doesntfazer/Ch55p34-keyboard/BOM/BOMJLC.csv

Comment | Designator | Footprint | LCSC Part #
1N4148W | D1, D2, D3, D4, D5, D6, D7, D8, D9, D10, D11, D12, D13, D14, D15, D16, D17, D18, D19, D20, D21, D22, D23, D24, D25, D26, D27, D28, D29, D30, D31, D32, D33, D34 | D_SOD-123 | C25133
5.1k | R1, R2 | R_0805_2012Metric | C27834
330R | R3 | R_0805_2012Metric | C17630
10K | R4 | R_0805_2012Metric | C17414
100n | C1, C2, C3 | C_0805_2012Metric | C49678
CH552T | U1 | TSSOP-20_4.4x6.5mm_P0.65mm | C111367
Type-C | J1 | USB_C_Receptacle_HRO_TYPE-C-31-M-12 | C165948
