doesntfazer/Ch55p34-keyboard/Case Files/midplate.stl

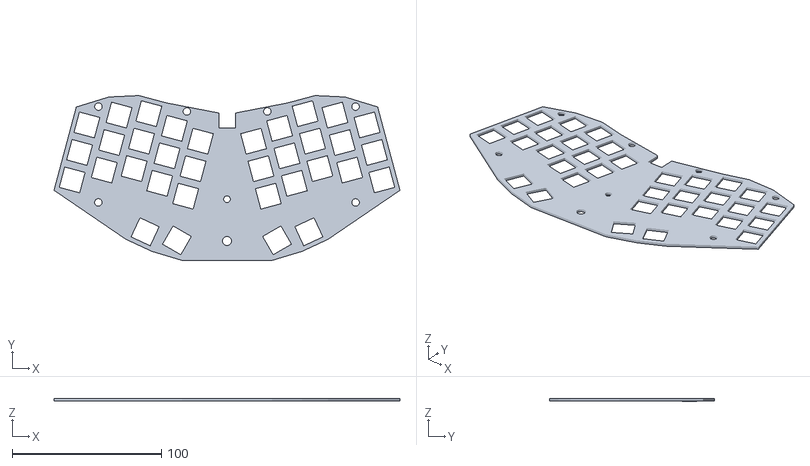
[picture p3: CAD file, 2024-01-23]
Case Files/midplate.stl
231.6 x 110.4 x 2.00
