doesntfazer/Ch55p34-keyboard/DXF/ch55p34-F_Cu.dxf

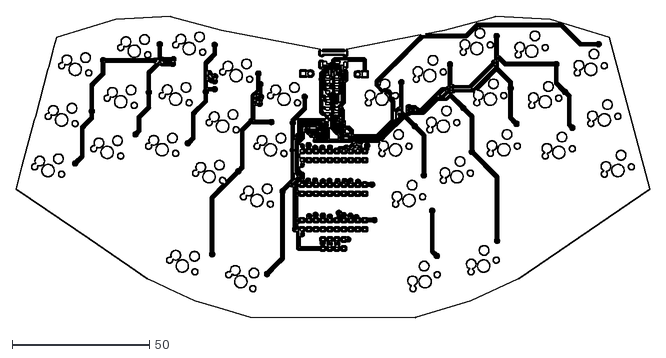
[picture p4: CAD file, 2024-01-17]
DXF/ch55p34-F_Cu.dxf
230.6 x 109.5
