doesntfazer/Ch55p34-keyboard/Case Files/Case.stl

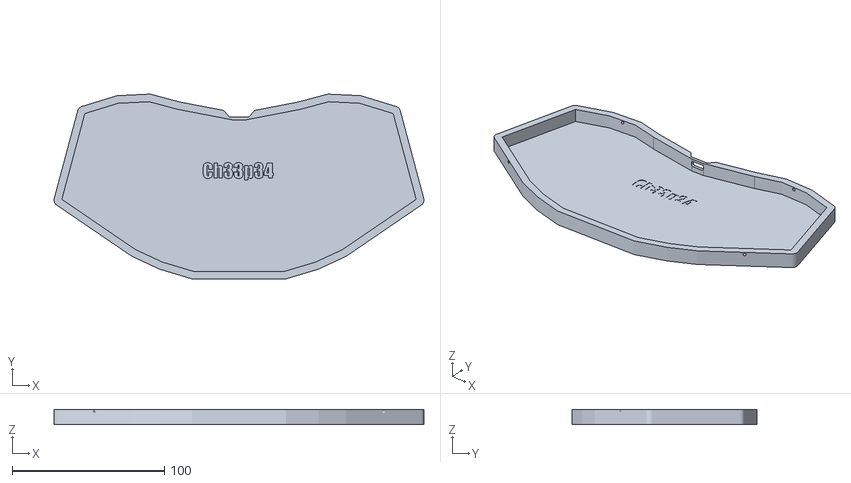
[picture p5: CAD file, 2024-01-17]
Case Files/Case.stl
243.1 x 121.4 x 10.0
