doesntfazer/Ch55p34-keyboard/DXF/ch55p34-F_Fab.dxf

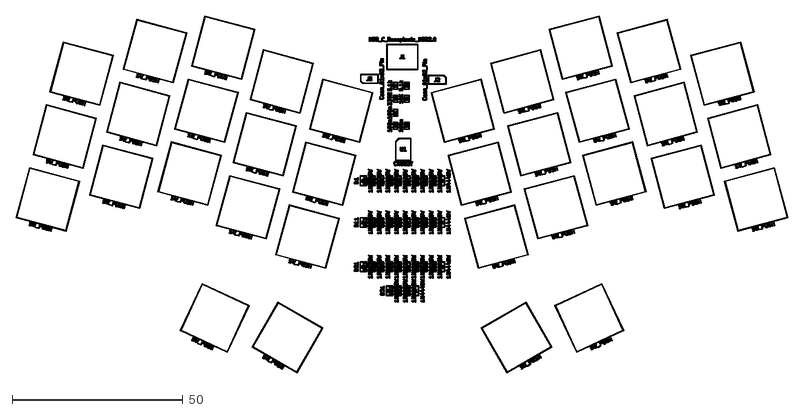
[picture p6: CAD file, 2024-01-17]
DXF/ch55p34-F_Fab.dxf
225.8 x 104.4
