doesntfazer/Ch55p34-keyboard/Case Files/plate.stl

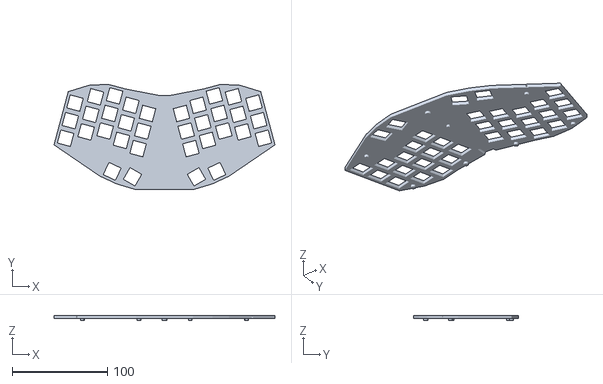
[picture p7: CAD file, 2024-01-17]
Case Files/plate.stl
231.6 x 110.4 x 5.00
