doesntfazer/Ch55p34-keyboard/DXF/ch55p34-Edge_Cuts.dxf

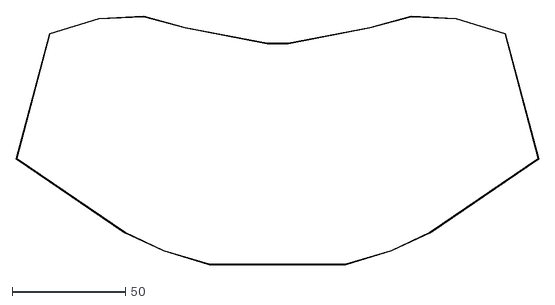
[picture p8: CAD file, 2024-01-17]
DXF/ch55p34-Edge_Cuts.dxf
230.7 x 109.6
