doesntfazer/Ch55p34-keyboard/(list of files, cad)

Other CAD files:
DXF/ch55p34-B_Mask.dxf
DXF/ch55p34-B_Paste.dxf
DXF/ch55p34-B_Silkscreen.dxf
DXF/ch55p34-F_Mask.dxf
DXF/ch55p34-F_Paste.dxf
DXF/ch55p34-F_Silkscreen.dxf
