doesntfazer/Ch55p34-keyboard/ch55p34/ch55p34.kicad_sch

## KiCad design ch55p34/ch55p34.kicad_sch (2024-01-05)

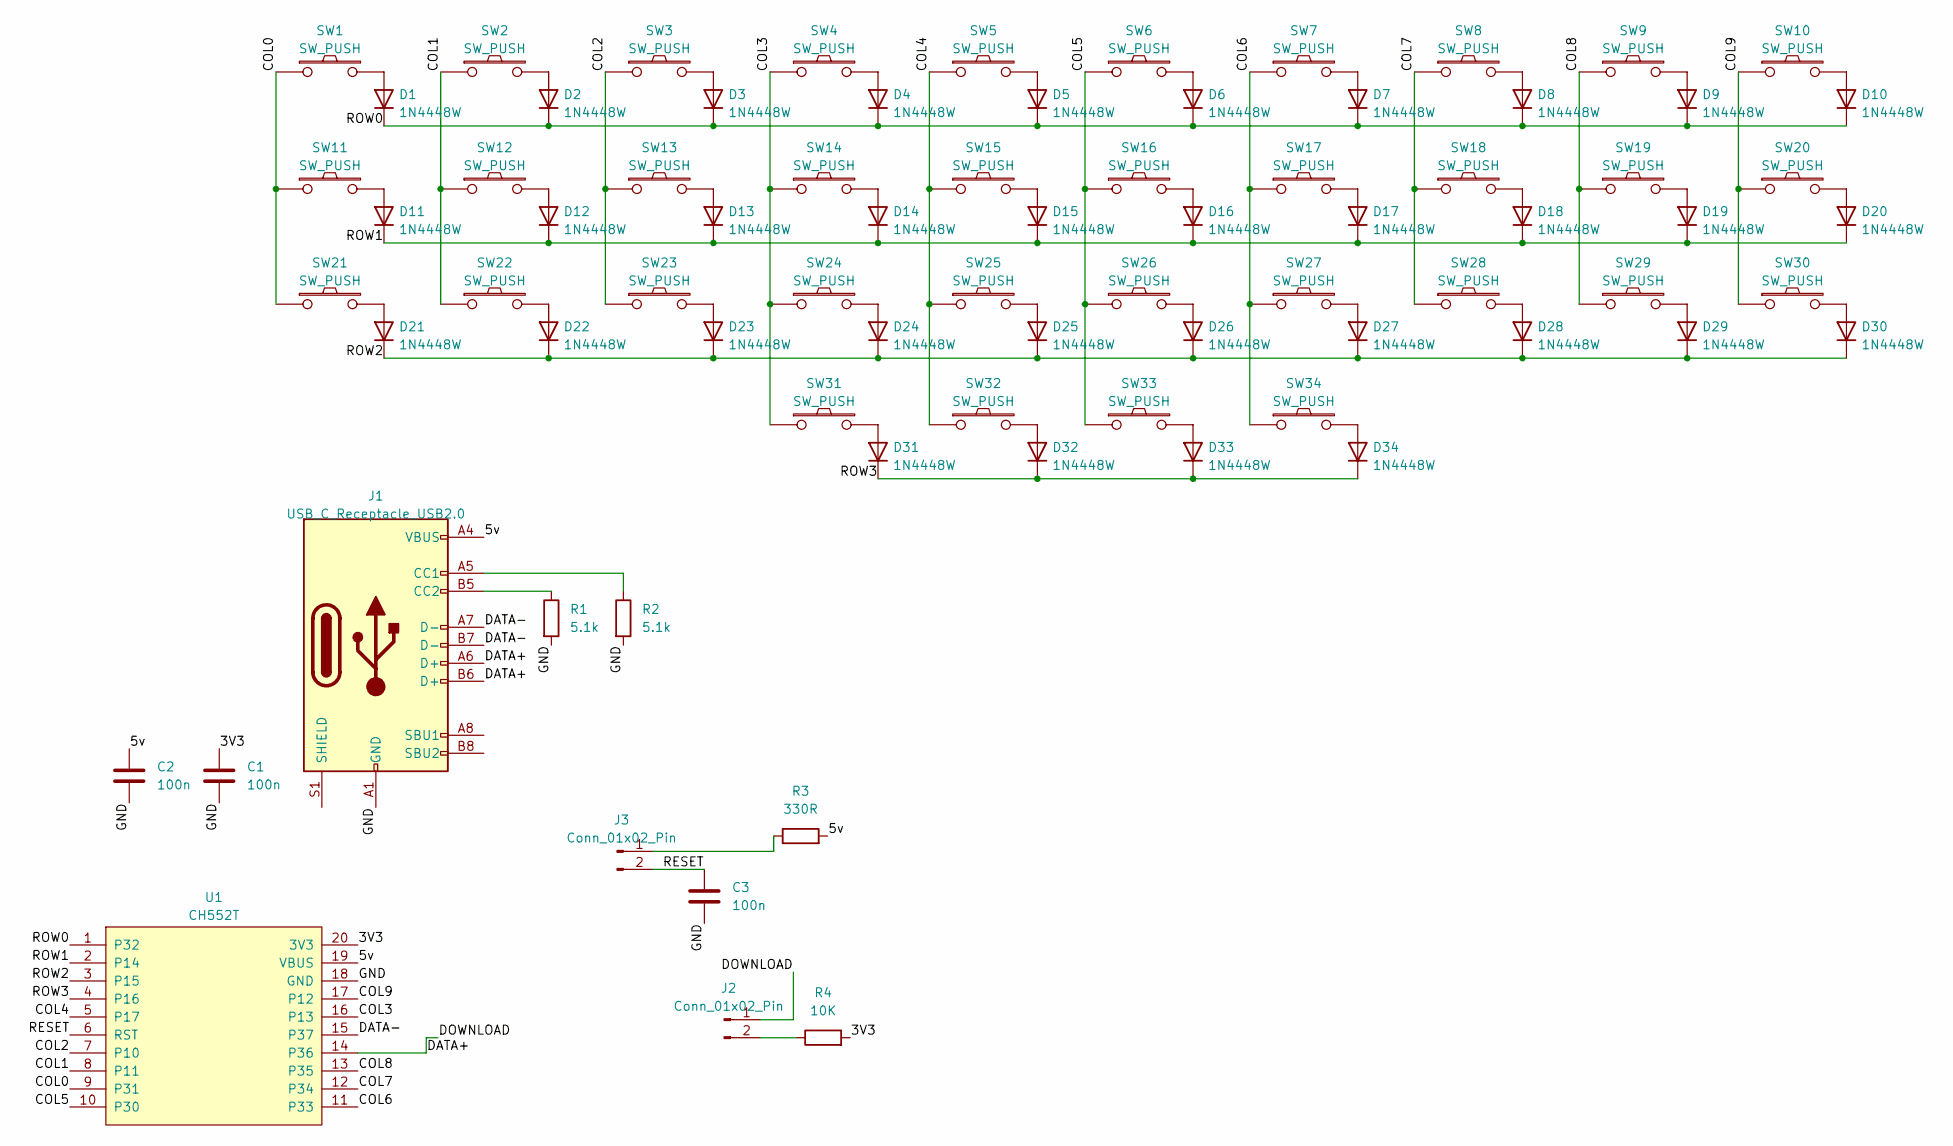
[picture p10: schematic ch55p34.kicad_sch]

Parts:
C1, C2, C3: 100n; C_0805_2012Metric; LCSC C49678
D1: 1N4448W; D_SOD-123; LCSC C9808
D2, D3, D4, D5, D6, D7, D8, D9, D10, D11, D12, D13, D14, D15, D16, D17, D18, D19, D20, D21, D22, D23, D24, D25, D26, D27, D28, D29, D30, D31, D32, D33, D34: 1N4448W; D_SOD-123
J1: USB_C_Receptacle_USB2.0; USB_C_Receptacle_HRO_TYPE-C-31-M-12
J2, J3: Conn_01x02_Pin; PinHeader_1x02_P2.54mm_Vertical
R1, R2: 5.1k; R_0805_2012Metric; LCSC C27834
R3: 330R; R_0805_2012Metric; LCSC C17630
R4: 10K; R_0805_2012Metric; LCSC C17414
SW1, SW2, SW3, SW4, SW5, SW6, SW7, SW8, SW9, SW10, SW11, SW12, SW13, SW14, SW15, SW16, SW17, SW18, SW19, SW20, SW21, SW22, SW23, SW24, SW25, SW26, SW27, SW28, SW29, SW30, SW31, SW32, SW33, SW34: SW_PUSH; Kailh_socket_MX
U1: CH552T; TSSOP-20_4.4x6.5mm_P0.65mm; LCSC C111367

Connections:
3V3: C1.1, R4.2, U1.20 (3V3)
5v: C2.1, J1.A4 (VBUS), J1.A9 (VBUS), J1.B4 (VBUS), J1.B9 (VBUS), R3.2, U1.19 (VBUS)
COL0: SW1.1, SW11.1, SW21.1, U1.9 (P31)
COL1: SW2.1, SW12.1, SW22.1, U1.8 (P11)
COL2: SW3.1, SW13.1, SW23.1, U1.7 (P10)
COL3: SW4.1, SW14.1, SW24.1, SW31.1, U1.16 (P13)
COL4: SW5.1, SW15.1, SW25.1, SW32.1, U1.5 (P17)
COL5: SW6.1, SW16.1, SW26.1, SW33.1, U1.10 (P30)
COL6: SW7.1, SW17.1, SW27.1, SW34.1, U1.11 (P33)
COL7: SW8.1, SW18.1, SW28.1, U1.12 (P34)
COL8: SW9.1, SW19.1, SW29.1, U1.13 (P35)
COL9: SW10.1, SW20.1, SW30.1, U1.17 (P12)
DATA+: J1.A6 (D+), J1.B6 (D+), J2.1, U1.14 (P36)
DATA-: J1.A7 (D-), J1.B7 (D-), U1.15 (P37)
GND: C1.2, C2.2, C3.2, J1.A1 (GND), J1.A12 (GND), J1.B1 (GND), J1.B12 (GND), R1.2, R2.2, U1.18 (GND)
unnamed: D1.2 (A), SW1.2
unnamed: D2.2 (A), SW2.2
unnamed: D3.2 (A), SW3.2
unnamed: D4.2 (A), SW4.2
unnamed: D5.2 (A), SW5.2
unnamed: D6.2 (A), SW6.2
unnamed: D7.2 (A), SW7.2
unnamed: D8.2 (A), SW8.2
unnamed: D9.2 (A), SW9.2
unnamed: D10.2 (A), SW10.2
unnamed: D11.2 (A), SW11.2
unnamed: D12.2 (A), SW12.2
unnamed: D13.2 (A), SW13.2
unnamed: D14.2 (A), SW14.2
unnamed: D15.2 (A), SW15.2
unnamed: D16.2 (A), SW16.2
unnamed: D17.2 (A), SW17.2
unnamed: D18.2 (A), SW18.2
unnamed: D19.2 (A), SW19.2
unnamed: D20.2 (A), SW20.2
unnamed: D21.2 (A), SW21.2
unnamed: D22.2 (A), SW22.2
unnamed: D23.2 (A), SW23.2
unnamed: D24.2 (A), SW24.2
unnamed: D25.2 (A), SW25.2
unnamed: D26.2 (A), SW26.2
unnamed: D27.2 (A), SW27.2
unnamed: D28.2 (A), SW28.2
unnamed: D29.2 (A), SW29.2
unnamed: D30.2 (A), SW30.2
unnamed: D31.2 (A), SW31.2
unnamed: D32.2 (A), SW32.2
unnamed: D33.2 (A), SW33.2
unnamed: D34.2 (A), SW34.2
unnamed: J1.A5 (CC1), R2.1
unnamed: J1.B5 (CC2), R1.1
unnamed: J2.2, R4.1
unnamed: J3.1, R3.1
RESET: C3.1, J3.2, U1.6 (RST)
ROW0: D1.1 (K), D2.1 (K), D3.1 (K), D4.1 (K), D5.1 (K), D6.1 (K), D7.1 (K), D8.1 (K), D9.1 (K), D10.1 (K), U1.1 (P32)
ROW1: D11.1 (K), D12.1 (K), D13.1 (K), D14.1 (K), D15.1 (K), D16.1 (K), D17.1 (K), D18.1 (K), D19.1 (K), D20.1 (K), U1.2 (P14)
ROW2: D21.1 (K), D22.1 (K), D23.1 (K), D24.1 (K), D25.1 (K), D26.1 (K), D27.1 (K), D28.1 (K), D29.1 (K), D30.1 (K), U1.3 (P15)
ROW3: D31.1 (K), D32.1 (K), D33.1 (K), D34.1 (K), U1.4 (P16)
