doesntfazer/Ch55p34-keyboard/FAK-Firmware/src/main.c

#include "ch552.h"
#include "keyboard.h"
#include "time.h"

#ifdef SPLIT_SIDE_CENTRAL
#include "usb.h"

void USB_interrupt();
void USB_ISR() __interrupt(INT_NO_USB) {
    USB_interrupt();
}
#endif

void TMR0_interrupt();
void TMR0_ISR() __interrupt(INT_NO_TMR0) {
    TMR0_interrupt();
}

#if defined(SPLIT_ENABLE) && defined(SPLIT_SIDE_PERIPHERAL)
void UART_interrupt();
void UART_ISR() __interrupt(INT_NO_UART0) {
    UART_interrupt();
}
#endif

void main() {
    CLK_init();
#ifdef SPLIT_SIDE_CENTRAL
    TMR0_init();
    USB_init();
#endif
    keyboard_init();

#ifdef UART0_ALT
    PIN_FUNC |= bUART0_PIN_X;
#endif
#ifdef UART1_ALT
    PIN_FUNC |= bUART1_PIN_X;
#endif

    EA = 1;

    while (1) {
        keyboard_scan();
    }
}
