doesntfazer/Ch55p34-keyboard/(commit log)

2024-01-17 added case and firmware
    [Case.stl, ch55p34-B_Cu.dxf, ch55p34-B_Mask.dxf, ch55p34-B_Paste.dxf, ch55p34-B_Silkscreen.dxf, ch55p34-Edge_Cuts.dxf, ch55p34-F_Cu.dxf, ch55p34-F_Fab.dxf]
2024-01-23 Added a midplate
    The midplate goes between the plate and the PCB It changes the sound profile. Print in TPU.
    [midplate.stl]
